nikita-do/VX-Firmware/README.md

# VitalX Firmware

This repository contains the firmware for the pain detection device based on ECG, PPG and EDA/GSR signals. The implementation focuses on reading these from hardware, batching them in memory, packaging, and sending them to a remote broker for analysis and visualization.

### 1. Sensor acquisition

The firmware reads two categories of signals:

- GSR and ECG through the ESP32 ADC inputs
- IR and red PPG values through the ADPD144 sensor

The code uses:

- ADC calibration for reliable analog-to-digital conversion
- oneshot ADC configuration for low-overhead sampling
- FreeRTOS timers to trigger sensor reads at a fixed rate

Current runtime configuration:

- Sampling rate: 512 Hz
- Batch size: 512 samples
- Payload encoding: CBOR

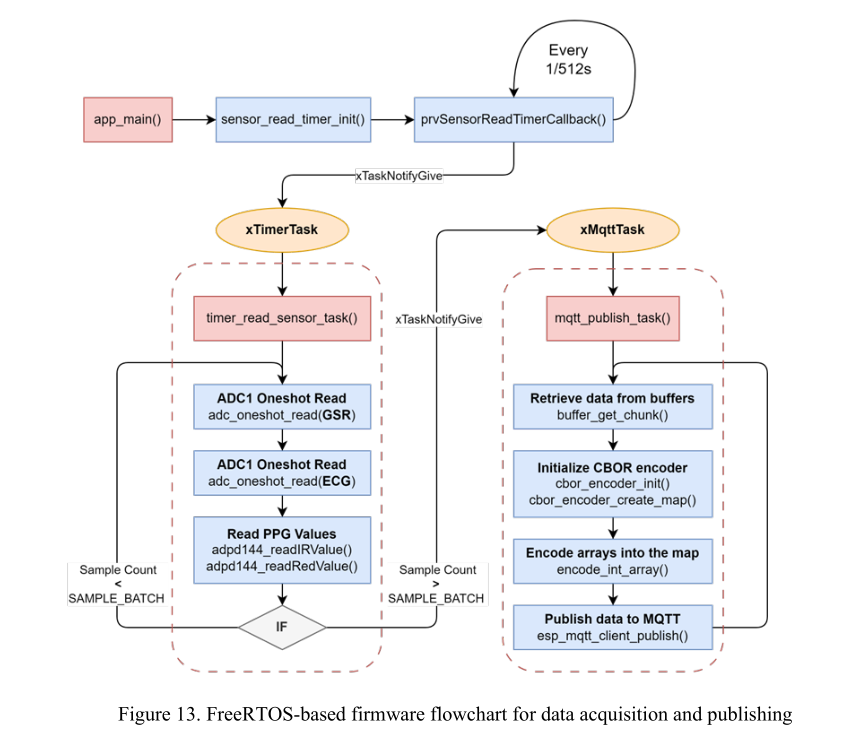
[picture p1: assets/freertos.png]
FreeRTOS sampling and publish flow


### 2. Real-time buffering

The firmware uses circular buffers to handle continuous sampling without blocking or dropping data. Each signal stream has its own buffer:

- GSR buffer
- ECG buffer
- IR buffer
- Red buffer

The sensor task writes samples continuously, and the publish task reads out a full batch later for encoding and publishing.

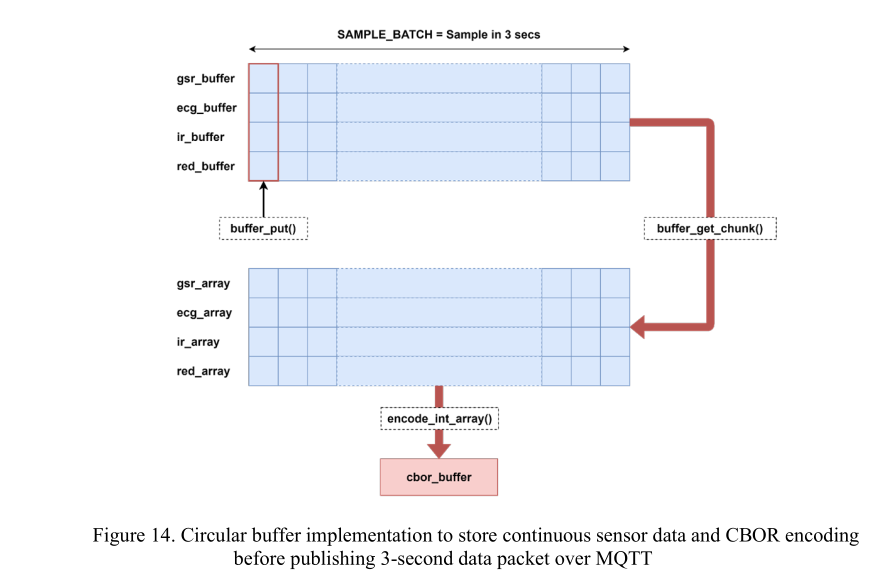
[picture p2: assets/buffer.png]
Circular buffer and CBOR encoding flow


### 3. MQTT communication

The device communicates with a secure MQTT broker using the ESP-IDF MQTT client. The implementation is built around asynchronous event handling, the firmware reacts to connection events, subscriptions, received commands, and errors without blocking the main data path.

The firmware publishes:

- device online status
- firmware version
- sampling metadata
- RSSI information
- CBOR-encoded sensor batches

It also subscribes to command topics to support remote control:

- start data publishing
- stop data publishing
- restart/reset the device

The topic design is intentionally device-scoped, so each ESP32 instance keeps its own data stream and command channels. The device topics are highlighted below.

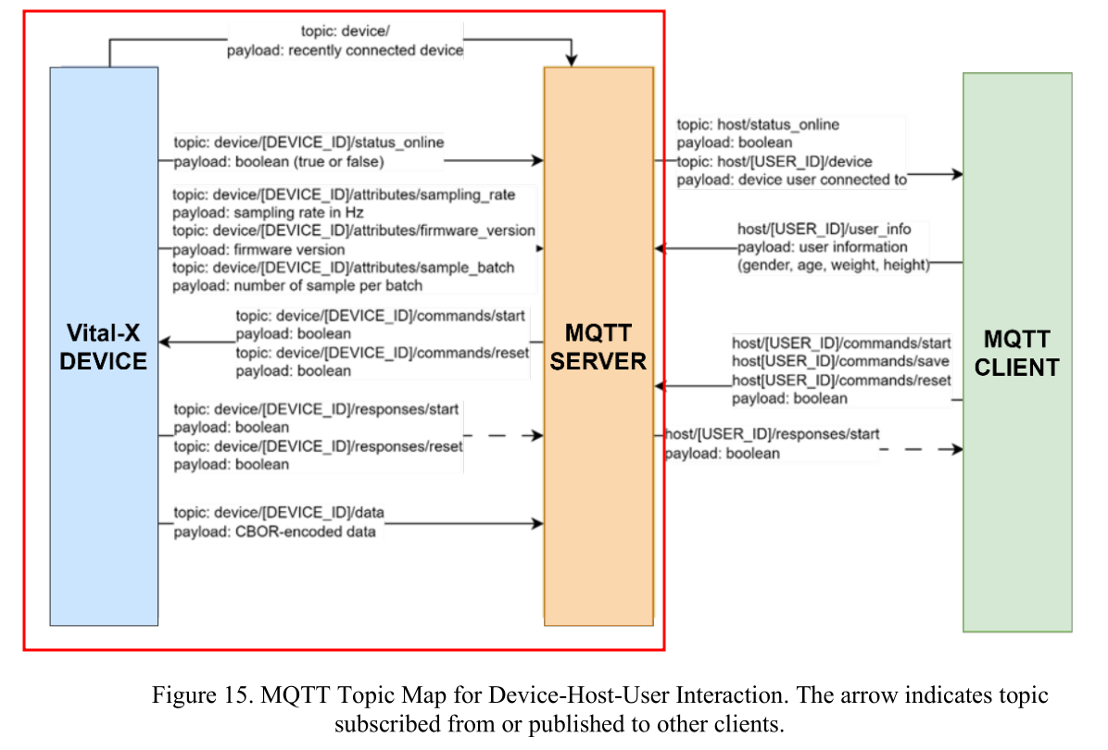
[picture p3: assets/mqtt-topic.png]
MQTT topic map


### 4. Wi-Fi provisioning and connectivity

The device includes Wi-Fi provisioning support using the ESP-IDF provisioning framework. The firmware can be configured at runtime instead of hardcoding credentials into firmware.

The implementation includes:

- SoftAP or BLE provisioning flow
- QR-provisioning support
- NVS-backed credential storage
- reconnect logic after connection loss
- reset/reprovisioning support

### 5. Time synchronization

The firmware synchronizes the local clock using SNTP before producing timestamped sensor packets. This matters because the sensor data is grouped into batches and then published to MQTT. Without a valid time source, the downstream analytics side has no reliable chronology for the readings.

### 6. Device health and operational status

The firmware also includes a few common reliability features:

- LED status indication for connection state
- last-will MQTT messages for offline detection
- restart after repeated disconnects
- optional heap monitoring for debugging memory issues

## Firmware structure

```text
firmware/
└── esp32-VitalX/
    ├── CMakeLists.txt
    ├── sdkconfig
    ├── components/
    │   └── adpd144/
    ├── main/
    │   ├── app_main.c
    │   ├── app_main.h
    │   ├── app_adc.c
    │   ├── app_mqtt.c
    │   ├── app_time.c
    │   ├── circular_buffer.c
    │   ├── wifi_prov.c
    │   ├── Kconfig.projbuild
    │   └── idf_component.yml
    └── managed_components/
```

Key firmware files:

- app_main.c: main application loop, sensor batching, MQTT control, task scheduling
- app_adc.c: ADC calibration and reading logic
- app_mqtt.c: MQTT client configuration and event handling
- app_time.c: SNTP and timestamp handling
- wifi_prov.c: Wi-Fi provisioning and connection flow
- circular_buffer.c: ring-buffer implementation for the sensor streams
- Kconfig.projbuild: custom project configuration for MQTT and Wi-Fi settings

## Build notes

This project uses the ESP-IDF framework and is configured as an ESP32-S2 firmware target.

## References

- ESP-IDF: https://docs.espressif.com/projects/esp-idf/en/latest/esp32/index.html
- ESP SoftAP Provisioning:
https://play.google.com/store/apps/details?id=com.espressif.provsoftap&pcampaignid=web_s
hare
- FreeRTOS: https://www.freertos.org/media/2018/FreeRTOS_Reference_Manual_V10.0.0.pdf
- CBOR Encoding: https://cborbook.com/part_1/practical_introduction_to_cbor.html

---

This README summarizes the implementation that was completed in the current firmware codebase.
