nikita-do/VX-Firmware/assets/system-architecture.png

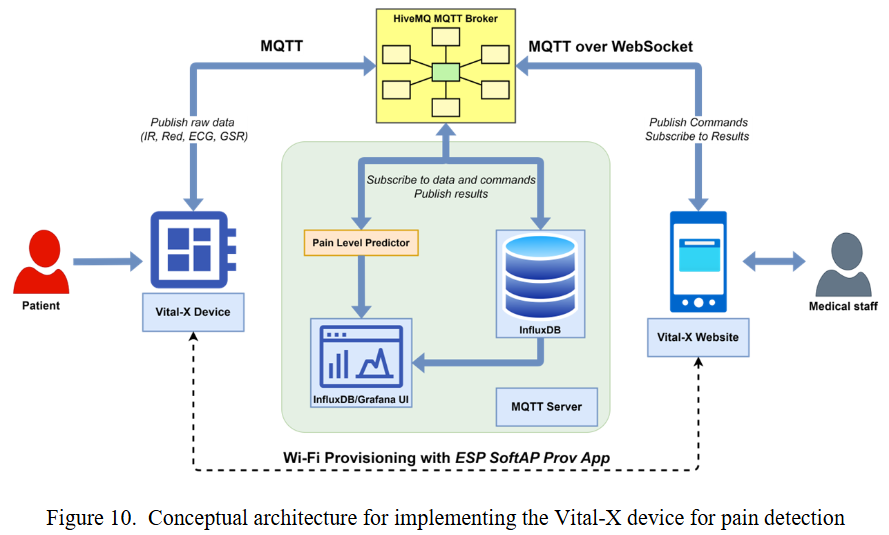
assets/system-architecture.png
