nikita-do/VX-Firmware/hardware/customLib/AD8232ACPZ-R7/AD8232ACPZ-R7.STEP

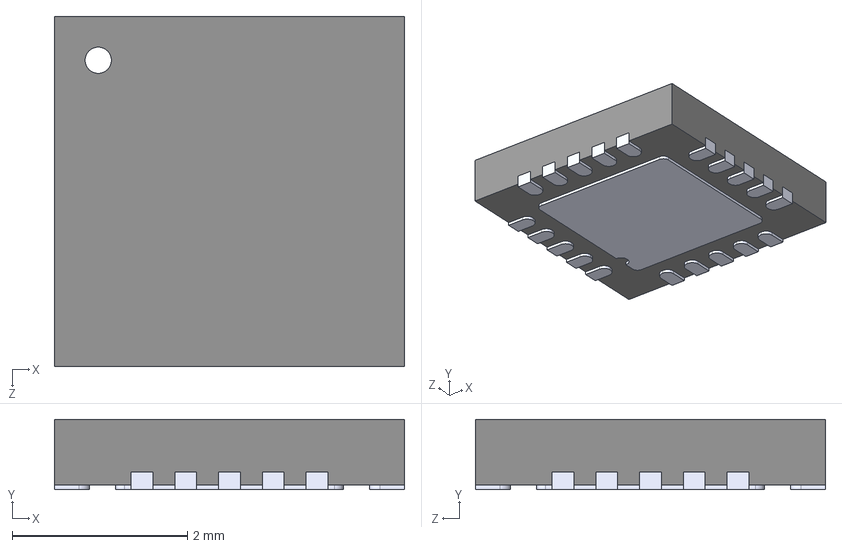
[picture p5: CAD file, 2024-07-22, last stored version]
hardware/customLib/AD8232ACPZ-R7/AD8232ACPZ-R7.STEP
4.00 x 0.8 x 4.00 mm
