nikita-do/VX-Firmware/hardware/customLib/ADP160AUJZ-1-8-R7/ADP160AUJZ-1-8-R7.step

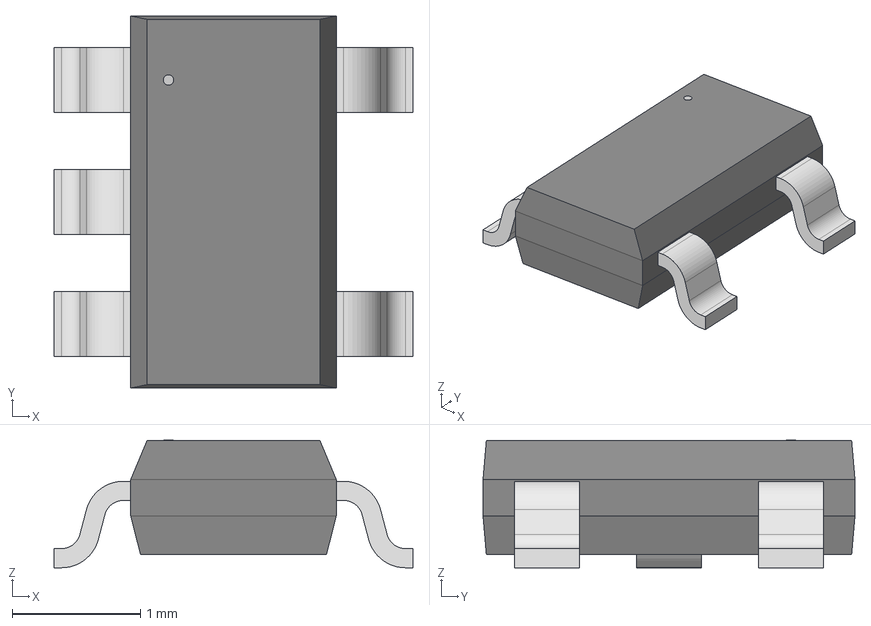
[picture p6: CAD file, 2024-07-22, last stored version]
hardware/customLib/ADP160AUJZ-1-8-R7/ADP160AUJZ-1-8-R7.step
2.79 x 2.90 x 0.993 mm
