nikita-do/VX-Firmware/hardware/customLib/ADPD144RI/CE-12-2_ADI.step

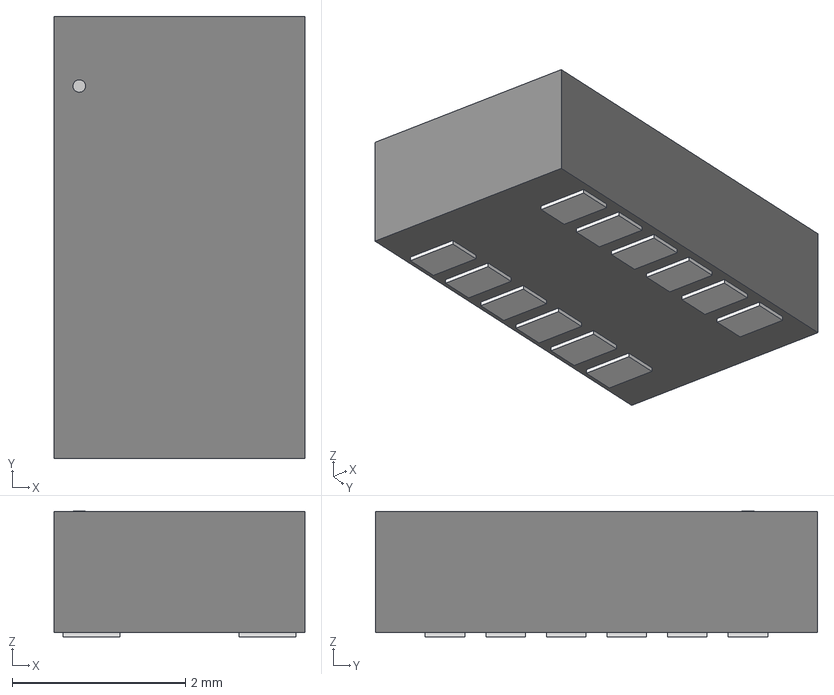
[picture p7: CAD file, 2025-03-10, last stored version]
hardware/customLib/ADPD144RI/CE-12-2_ADI.step
2.90 x 5.11 x 1.45 mm
