nikita-do/VX-Firmware/hardware/customLib/AUDIO/SJ2-3574A-SMT-TR/SJ2-3574A-SMT-TR.step

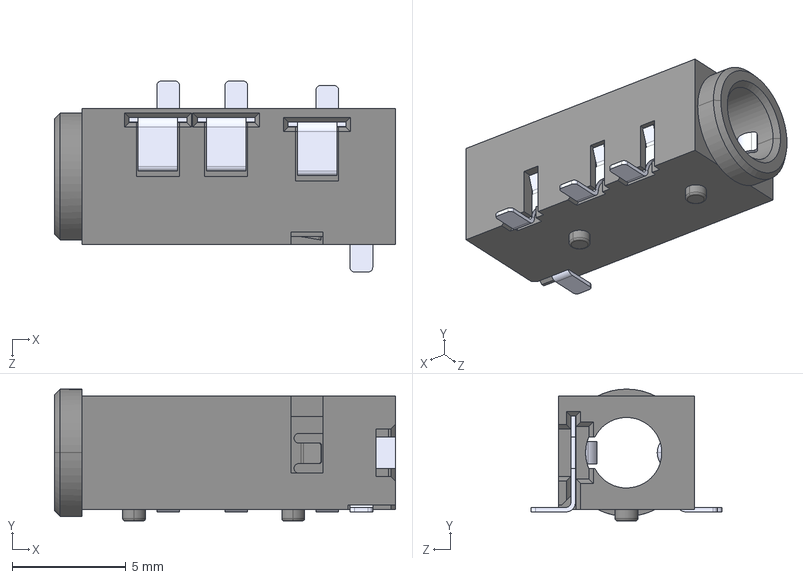
[picture p8: CAD file, 2024-07-22, last stored version]
hardware/customLib/AUDIO/SJ2-3574A-SMT-TR/SJ2-3574A-SMT-TR.step
15.0 x 5.80 x 8.40 mm
