nikita-do/VX-Firmware/hardware/customLib/AUDIO/SJ2-3593D-SMT-TR/SJ2-3593D-SMT-TR.step

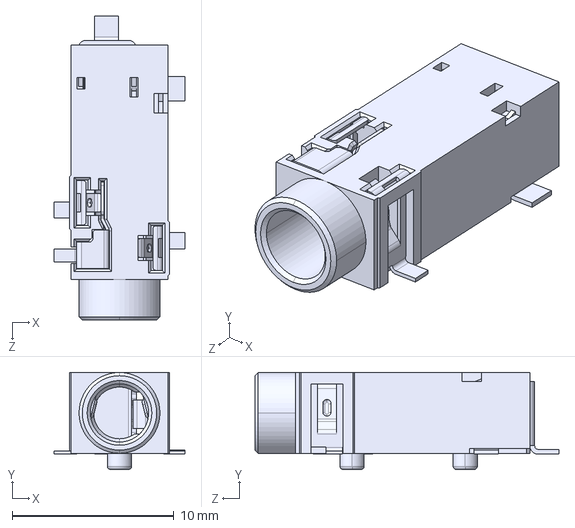
[picture p9: CAD file, 2024-07-22, last stored version]
hardware/customLib/AUDIO/SJ2-3593D-SMT-TR/SJ2-3593D-SMT-TR.step
8.10 x 6.00 x 18.8 mm
