nikita-do/VX-Firmware/hardware/VitalX-ESP/VitalX-ESP.kicad_pcb

## KiCad design hardware/VitalX-ESP/VitalX-ESP.kicad_pcb (2025-03-10, last stored version)

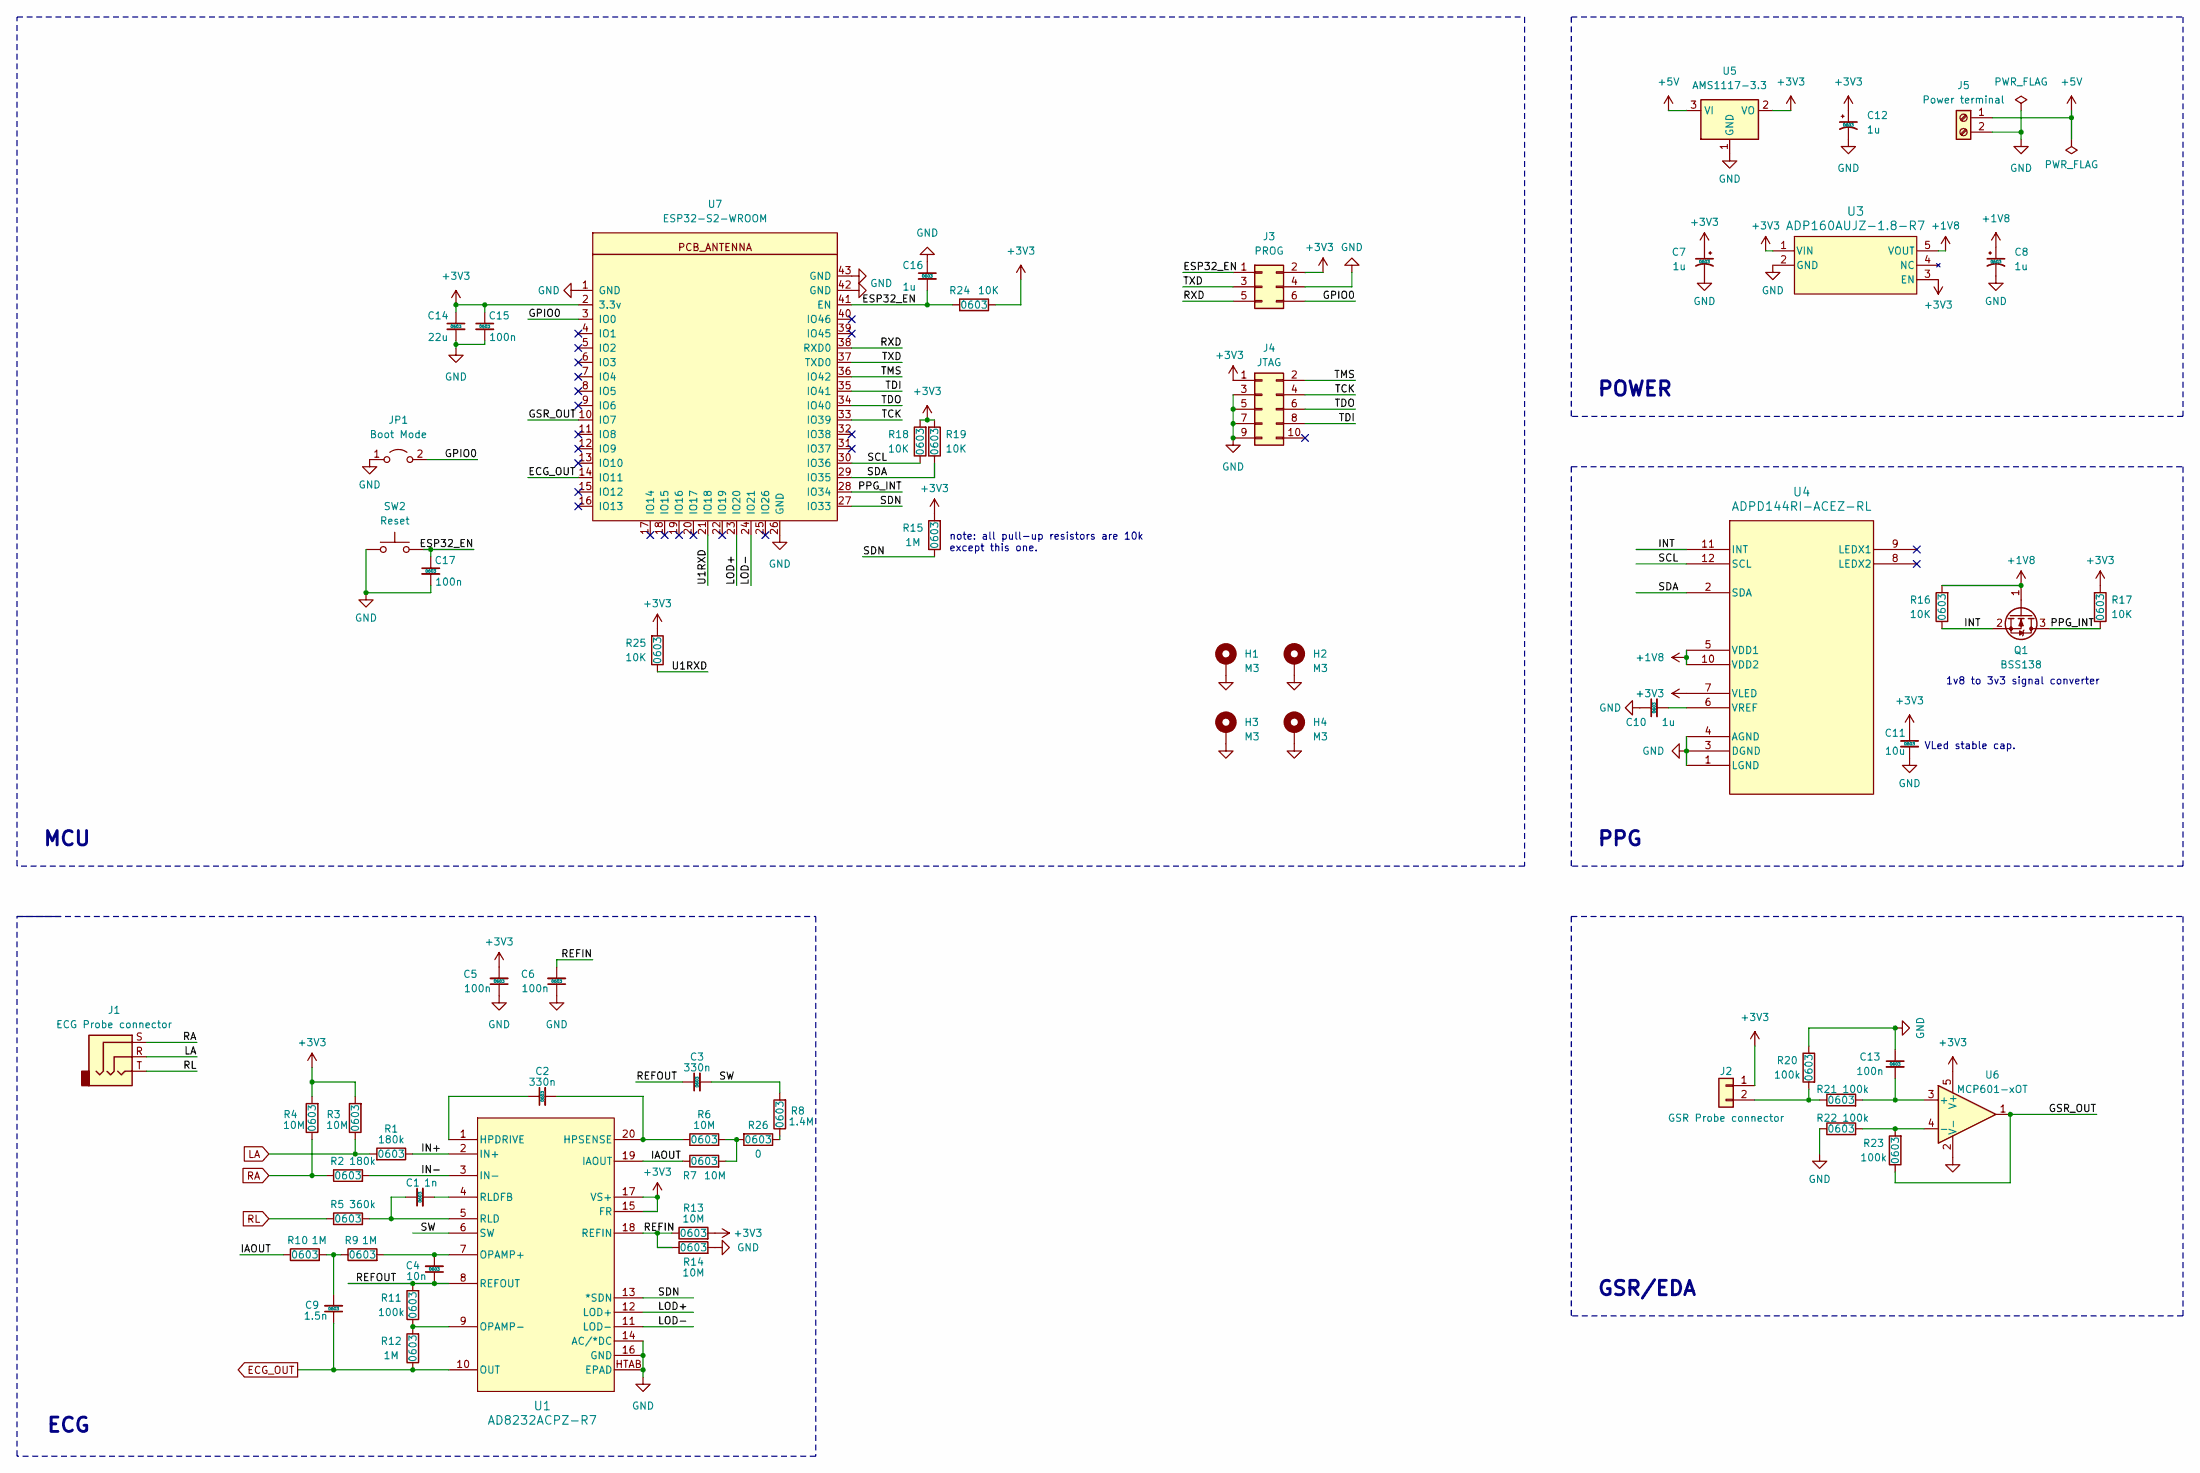
[picture p10: schematic VitalX-ESP.kicad_sch, Vital X]

Parts:
C1: 1n; C_0603_1608Metric
C2, C3: 330n; C_0603_1608Metric
C4: 10n; C_0603_1608Metric
C5, C6, C13, C15, C17: 100n; C_0603_1608Metric
C7, C8, C10, C12, C16: 1u; C_0603_1608Metric
C9: 1.5n; C_0603_1608Metric
C11: 10u; C_0603_1608Metric
C14: 22u; C_0603_1608Metric
H1, H2, H3, H4: M3; MountingHole_3.2mm_M3_Pad_Via
J1: ECG Probe connector; SJ2-3593D-SMT-TR
J2: GSR Probe connector; PinHeader_1x02_P2.54mm_Vertical
J3: PROG; PinHeader_2x03_P2.54mm_Vertical
J4: JTAG; PinHeader_2x05_P2.54mm_Vertical
J5: Power terminal; TerminalBlock_bornier-2_P5.08mm
JP1: Boot Mode; PinHeader_1x02_P2.54mm_Vertical
Q1: BSS138; SOT-23; mouser mnf num 512-BSS138
R1, R2: 180k; R_0603_1608Metric
R3, R4, R6, R7, R13, R14: 10M; R_0603_1608Metric
R5: 360k; R_0603_1608Metric
R8: 1.4M; R_0603_1608Metric
R9, R10, R12, R15: 1M; R_0603_1608Metric
R11, R20, R21, R22, R23: 100k; R_0603_1608Metric
R16, R17, R18, R19, R24, R25: 10K; R_0603_1608Metric
R26: 0; R_0603_1608Metric
SW2: Reset; SW_Tactile_SPST_NO_Straight_CK_PTS636Sx25SMTRLFS
U1: AD8232ACPZ-R7; AD8232ACPZ; mouser mnf num 584-AD8232ACPZ-R7
U3: ADP160AUJZ-1.8-R7; ADP160AUJZ-1-8-R7; mouser mnf num 584-ADP160AUJZ-1.8R7
U4: ADPD144RI-ACEZ-RL; CE-12-2_ADI; mouser mnf num 584-ADPD144RI-ACEZRL
U5: AMS1117-3.3; SOT-223-3_TabPin2; mouser mnf num 926-LM1117MPX3.3NOPB
U6: MCP601-xOT; SOT-23-5; mouser mnf num 579-MCP601RT-E/OT
U7: ESP32-S2-WROOM; esp32-s2-wrooom; mouser mnf num 356-ESP32S2WRMI320US

Connections:
+1V8: C8.1, Q1.1 (G), R16.2, U3.5 (VOUT), U4.5 (VDD1), U4.10 (VDD2)
+3V3: C5.2, C7.1, C11.1, C12.1, C14.1, C15.1, J2.1, J3.2, J4.1, R3.2, R4.2, R13.2, R15.2, R17.2, R18.2, R19.2, R24.1, R25.2, U1.15 (FR), U1.17 (VS+), U3.1 (VIN), U3.3 (EN), U4.7 (VLED), U5.2 (VO), U6.5 (V+), U7.2 (3.3v)
+5V: J5.1, U5.3 (VI)
/ESP32_EN: C16.2, C17.1, J3.1, R24.2, SW2.2, U7.41 (EN)
/GPIO0: J3.6, JP1.2 (B), U7.3 (IO0)
/GSR_OUT: R23.1, U6.1, U7.10 (IO7)
/IAOUT: R7.1, R10.1, U1.19 (IAOUT)
/IN+: R1.1, U1.2 (IN+)
/IN-: R2.2, U1.3 (IN-)
/INT: Q1.2 (S), R16.1, U4.11 (INT)
/LOD+: U1.12 (LOD+), U7.23 (IO20)
/LOD-: U1.11 (LOD-), U7.24 (IO21)
/PPG_INT: Q1.3 (D), R17.1, U7.28 (IO34)
/REFIN: C6.2, R13.1, R14.1, U1.18 (REFIN)
/REFOUT: C3.1, C4.1, R11.2, U1.8 (REFOUT)
/RXD: J3.5, U7.38 (RXD0)
/SCL: R18.1, U4.12 (SCL), U7.30 (IO36)
/SDA: R19.1, U4.2 (SDA), U7.29 (IO35)
/SDN: R15.1, U1.13 (*SDN), U7.27 (IO33)
/SW: C3.2, R8.2, U1.6 (SW)
/TCK: J4.4, U7.33 (IO39)
/TDI: J4.8, U7.35 (IO41)
/TDO: J4.6, U7.34 (IO40)
/TMS: J4.2, U7.36 (IO42)
/TXD: J3.3, U7.37 (TXD0)
/U1RXD: R25.1, U7.21 (IO18)
ECG_OUT: C9.1, R12.1, U1.10 (OUT), U7.14 (IO11)
GND: C5.1, C6.1, C7.2, C8.2, C10.1, C11.2, C12.2, C13.1, C14.2, C15.2, C16.1, C17.2, H1.1, H2.1, H3.1, H4.1, J3.4, J4.3, J4.5, J4.7, J4.9, J5.2, JP1.1 (A), R14.2, R20.1, R22.1, SW2.1, U1.14 (AC/*DC), U1.16 (GND), U1.HTAB (EPAD), U3.2 (GND), U4.1 (LGND), U4.3 (DGND), U4.4 (AGND), U5.1 (GND), U6.2 (V-), U7.1 (GND), U7.26 (GND), U7.42 (GND), U7.43 (GND)
LA: J1.R, R1.2, R3.1
unnamed: C9.2, R9.1, R10.2
unnamed: J2.2, R20.2, R21.1
unnamed: R8.1, R26.1
unnamed: R6.2, R7.2, R26.2
unnamed: C2.1, U1.1 (HPDRIVE)
unnamed: C2.2, R6.1, U1.20 (HPSENSE)
unnamed: C4.2, R9.2, U1.7 (OPAMP+)
unnamed: R11.1, R12.2, U1.9 (OPAMP-)
unnamed: C1.1, R5.2, U1.5 (RLD)
unnamed: C1.2, U1.4 (RLDFB)
unnamed: C10.2, U4.6 (VREF)
unnamed: C13.2, R21.2, U6.3 (+)
unnamed: R22.2, R23.2, U6.4 (-)
RA: J1.S, R2.1, R4.1
RL: J1.T, R5.1

Notes on the sheet:
MCU
PPG
1v8 to 3v3 signal converter
GSR/EDA
ECG
VLed stable cap.
note: all pull-up resistors are 10k except this one.
POWER

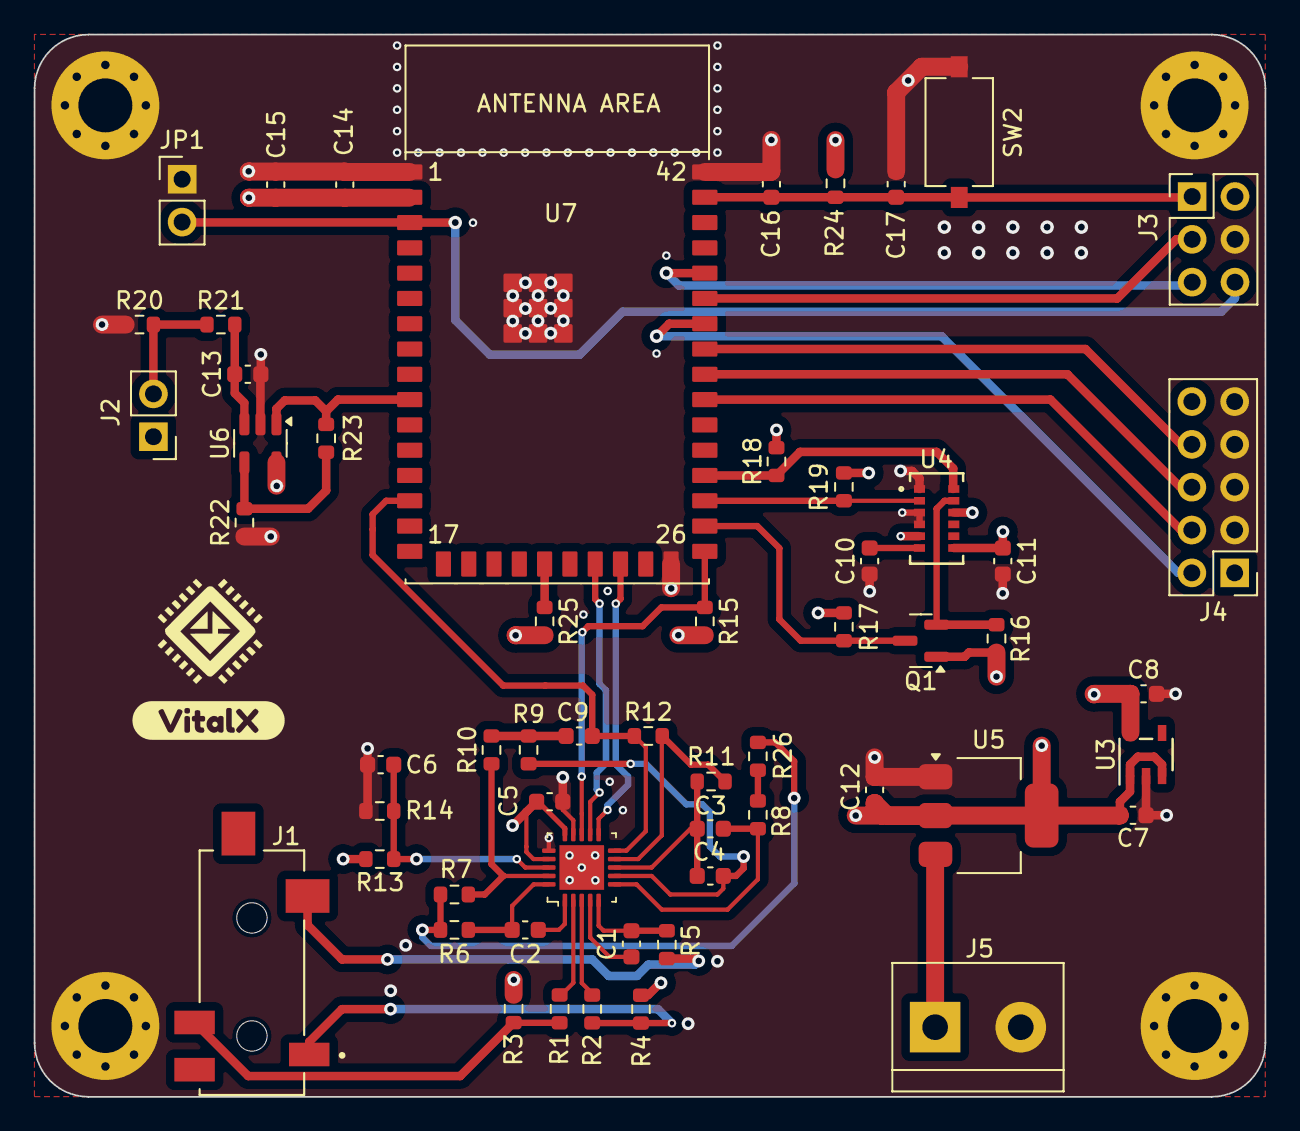
[picture p11: board VitalX-ESP.kicad_pcb from above]

Board: 4 copper layers, 73.0 x 63.0 mm, 62 parts (0 on the bottom side), 44 nets.

Other parts of the board:
kibuzzard-673C1CE7: G***; kibuzzard-673C1CE7
