nikita-do/VX-Firmware/firmware/esp32-VitalX/components/adpd144/adpd144.c

// Written for only one device on the i2c bus
/* ------------------------- Includes -------------------------------------- */
#include <stdint.h>
#include <stdlib.h>
#include "adpd144.h"
#include "esp_check.h"

i2c_adpd144_t dev_handle;

static const char LOG_TAG[] = "i2c-adpd";

// ADPD144 default configuration. Register's values is set in an array
const adpd144_register_t register_config[] = {
    {REG_MODE, 0x0001},                 // program mode
    {REG_SAMPLE_CLK, 0x0080},           // start the sample clock (32 kHz)
    {REG_INT_IO_CTL, 0x0005},           // enable interrupt drive
    {REG_SLOT_EN, 0x30A9},
    {REG_F_SAMPLE, 0x0001},             // sampling rate = 1000 Hz
    {REG_PD_LED_SELECT, 0x0116},        // 
    {REG_NUM_AVG, 0x0330},              // Average sample = 8
    {REG_SLOTA_CH1_OFFSET, 0x3FFF},     // not used
    {REG_SLOTA_CH2_OFFSET, 0x3FFF},     // not used
    {REG_SLOTA_CH3_OFFSET, 0x1FF0},     // half scale
    {REG_SLOTA_CH4_OFFSET, 0x1FF0},     // half scale
    {REG_SLOTB_CH1_OFFSET, 0x3FFF},     // not used
    {REG_SLOTB_CH2_OFFSET, 0x3FFF},     // not used
    {REG_SLOTB_CH3_OFFSET, 0x1FF0},
    {REG_SLOTB_CH4_OFFSET, 0x1FF0},
    {REG_ILED1_COARSE, 0x3005},
    {REG_ILED2_COARSE, 0x3007},
    {REG_ILED_FINE, 0x0207},
    {REG_SLOTA_LEDMODE, 0x0319},
    {REG_SLOTA_NUMPULSES, 0x0813},
    {REG_SLOTB_LEDMODE, 0x0319},
    {REG_SLOTB_NUMPULSES, 0x0813},
    {REG_SLOTA_AFEMODE, 0x21F3},
    {REG_SLOTB_AFEMODE, 0x21F3},
    {REG_SLOTA_GAIN, 0x1C36},           // TIA gain = 50k
    {REG_SLOTB_GAIN, 0x1C36},           // TIA gain = 50k
    {REG_ADC_TIMING, 0x0040},
    {REG_MODE, 0x0002},                 // sample mode
    {0xFF, 0xFFFF}                      // signal the end of list
};

/**
 *  @brief    Load ADPD default configuration
 *  @param    adpd144_register_t *cfg
 *  @retval   None
 */
void adpd144_loadConfig(const adpd144_register_t *cfg)
{
    uint8_t regAddr, i;
    uint16_t regData;
    if (cfg == 0)
        return;
    /* Clear the FIFO */
    adpd144_writeReg(REG_MODE, 1);      // Program mode
    adpd144_writeReg(REG_DATA_ACCESS_CTL, 1);      // Set the FIFO_ACCESS_ENA to 1
    adpd144_writeReg(REG_STATUS, 0x80FF); // Set the FIFO_FLUSH to 0x80FF
    adpd144_writeReg(REG_DATA_ACCESS_CTL, 0);      // Set the FIFO_ACCESS_ENA to 0
    i = 0;
    while (1)
    {
        /* Read the address and data from the config */
        regAddr = (uint8_t)(cfg[i].address);
        regData = (uint16_t)(cfg[i].value);
        i++;
        if (regAddr == 0xFF)
            break;
        /* Load the data into the ADPD registers */
        adpd144_writeReg(regAddr, regData);
    }
}

/**
 * @brief    Read Infrared Red value from Slot A
 * @param    data Pointer to store the read value
 * @param    len Length of data to read (1 for 16-bit, 2 for 32-bit)
 */
esp_err_t adpd144_readIRValue(uint32_t *data, uint8_t len)
{
    uint16_t anRxData[2] = {0};
    uint8_t regAddr[2];

    /* Time slot requiring access */
    adpd144_writeReg(REG_DATA_ACCESS_CTL, 1); // Prevent slot A data from updating

    if (len == 1)
    {
        regAddr[0] = REG_SLOTA_PD4_16_BIT; // Average data
    }
    else if (len == 2)
    {
        regAddr[0] = REG_SLOTA_PD4_LOW; // Low data-word 
        regAddr[1] = REG_SLOTA_PD4_HIGH; // High data-word 
    }
    else
    {
        ESP_LOGE(LOG_TAG, "Invalid length for adpd144_ReadReg_SlotA");
        return ESP_ERR_INVALID_ARG;
    }

    for (int i = 0; i < len; i++)
    {
        adpd144_readReg(regAddr[i], &anRxData[i]);
    }

    if (len == 1)
    {
        *data = anRxData[0];
    }
    else if (len == 2)
    {
        *data = (anRxData[1] << 16) + anRxData[0];
    }

    adpd144_writeReg(REG_DATA_ACCESS_CTL, 0); // Allow slot A data to update

    return ESP_OK;
}

/**
 * @brief    Read Red value from Slot B
 * @param    data Pointer to store the read value
 * @param    len Length of data to read (1 for 16-bit, 2 for 32-bit)
 */
esp_err_t adpd144_readRedValue(uint32_t *data, uint8_t len)
{
    uint16_t anRxData[2] = {0};
    uint8_t regAddr[2];

    /* Time slot requiring access */
    adpd144_writeReg(REG_DATA_ACCESS_CTL, 3); // Prevent slot B data from updating

    if (len == 1)
    {
        regAddr[0] = REG_SLOTB_PD4_16_BIT; // Average data
    }
    else if (len == 2)
    {
        regAddr[0] = REG_SLOTB_PD4_LOW; // Low data-word
        regAddr[1] = REG_SLOTB_PD4_HIGH; // High data-word
    }
    else
    {
        ESP_LOGE(LOG_TAG, "Invalid length for adpd144_ReadReg_SlotB");
        return ESP_ERR_INVALID_ARG;
    }

    for (int i = 0; i < len; i++)
    {
        adpd144_readReg(regAddr[i], &anRxData[i]);
    }

    if (len == 1)
    {
        *data = anRxData[0];
    }
    else if (len == 2)
    {
        *data = (anRxData[1] << 16) + anRxData[0];
    }

    adpd144_writeReg(REG_DATA_ACCESS_CTL, 0); // Allow slot B data to update

    return ESP_OK;
}

/**
 * @brief    Initialize the ADPD144 device
 * 
 * This function configures the I2C bus and initializes the ADPD144 device.
 * It reads the chip ID to verify communication.
 */
esp_err_t adpd144_init(void)
{
    esp_err_t ret = ESP_OK;

    ESP_LOGI(LOG_TAG, "Configuring i2c bus");
    i2c_master_bus_config_t i2c_bus_config = {
        .clk_source = I2C_CLK_SRC_DEFAULT,
        .i2c_port = PORT_NUMBER,
        .scl_io_num = I2C_SCL_IO_PIN,
        .sda_io_num = I2C_SDA_IO_PIN,
        .glitch_ignore_cnt = 7,
    };
    i2c_master_bus_handle_t bus_handle;
    ESP_ERROR_CHECK(i2c_new_master_bus(&i2c_bus_config, &bus_handle));

    dev_handle.i2c_dev_conf.scl_speed_hz = MASTER_FREQUENCY;
    dev_handle.i2c_dev_conf.device_address = DEVICE_ADDRESS;

    ret = i2c_master_bus_add_device(bus_handle, &dev_handle.i2c_dev_conf, &dev_handle.i2c_dev_handle);
    ESP_GOTO_ON_ERROR(ret, cleanup, LOG_TAG, "i2c new bus failed");

    /* Start reading the IC */
    uint16_t chip_id; // Buffer to store the received data

    adpd144_readReg(REG_CHIP_ID, &chip_id);
    ESP_LOGI(LOG_TAG, "ADPD144 REG_CHIP_ID: %x", chip_id);
    return ESP_OK;

cleanup:
    if (dev_handle.i2c_dev_handle)
    {
        ESP_ERROR_CHECK(i2c_master_bus_rm_device(dev_handle.i2c_dev_handle));
    }
    return ret;
}

/**
 * @brief  Start the ADPD144 device
 *
 * This function initializes the ADPD144 device with a default configuration.
 */
void adpd144_start(void)
{
    adpd144_loadConfig(register_config); // Load the default configuration
}

/**
 * @brief  Stop the ADPD144 device
 *
 * This function puts the ADPD144 into standby mode.
 */
void adpd144_stop(void)
{
    adpd144_writeReg(REG_MODE, 0);      // Standby mode
}

/** @brief  Synchronous register read from the ADPD
 *
 * @param  nAddr 8-bit register address
 * @param  *pnData Pointer to 16-bit register data value
 */
void adpd144_readReg(uint8_t nAddr, uint16_t *pnData)
{
    uint8_t anRxData[2];

    ESP_ERROR_CHECK(i2c_master_transmit_receive(dev_handle.i2c_dev_handle, &nAddr, REG_ADDR_NUM_BYTES, anRxData, REG_VALUE_NUM_BYTES, -1));

    *pnData = ((uint16_t)anRxData[0] << 8) + anRxData[1];
}

/** @brief  Synchronous register write to the ADPD
 *
 * @param  nAddr 8-bit register address
 * @param  nRegValue 16-bit register data value
 */
void adpd144_writeReg(uint8_t nAddr, uint16_t nRegValue)
{
    dev_handle.buffer[0] = nAddr;
    dev_handle.buffer[1] = (uint8_t)(nRegValue >> 8);
    dev_handle.buffer[2] = (uint8_t)(nRegValue);

    ESP_ERROR_CHECK(i2c_master_transmit(dev_handle.i2c_dev_handle, dev_handle.buffer,REG_ADDR_NUM_BYTES + sizeof(uint16_t), -1));
}

/* ------------------------- End of file ----------------------------------- */
