nikita-do/VX-Firmware/firmware/esp32-VitalX/main/app_main.h

/**
 * @file app_main.h
 * @brief Contain shared libraries, structures, functions, and macros between source files
 * @todo Create header files for each source file
 * 
 * @version 0.2.0
 * @date 2024-04-09
 * 
 */

#ifndef APP_MAIN_H
#define APP_MAIN_H

#define SAMPLING_RATE 512  // Hz                
#define N_SAMPLE 512 // Number of samples to be sent in one batch

#define LED_BLINK_PERIOD_DISCONNECTED 200 // ms
#define LED_BLINK_PERIOD_PROVISIONING 500 // ms

/* C-Standard headers */
#include <stdio.h>
#include <stdint.h>
#include <stddef.h>
#include <string.h>
#include <stdlib.h>
#include <inttypes.h>

/* FreeRTOS headers */
#include "freertos/FreeRTOS.h"
#include "freertos/task.h"
#include "freertos/event_groups.h"
#include "freertos/semphr.h"
#include "freertos/queue.h"

/* ESP32 supported headers */
#include "esp_log.h"
#include "esp_system.h"
#include "esp_event.h"
#include <nvs_flash.h>

#include "esp_adc/adc_oneshot.h"
#include "esp_adc/adc_cali.h"

// #include "driver/gpio.h"

extern char mqtt_topics_firmware_version[64];
extern char mqtt_topics_sampling_rate[64];
extern char mqtt_topics_sample_batch[64];
extern char mqtt_topics_status_online[64];
extern char mqtt_topics_commands[64];
extern char mqtt_topics_commands_start[64];
extern char mqtt_topics_commands_reset[64];
extern char mqtt_topics_responses_start[64];
extern char mqtt_topics_responses_reset[64];
extern char mqtt_topics_data[64];

// app_adc.c
typedef struct
{
    adc_unit_t adc_unit;                   // ADC unit
    adc_channel_t channel;                 // ADC channel
    adc_oneshot_unit_handle_t unit_handle; // ADC oneshot unit handle
    adc_cali_handle_t cali_handle;         // ADC calibration handle
    int raw_value;                         // Raw ADC reading
    int voltage_value;                         // Voltage reading in mV
} AdcConfig_t;

esp_err_t adc_calibration_init(adc_unit_t unit, adc_channel_t channel, adc_cali_handle_t *out_handle);
void adc_calibration_deinit(adc_cali_handle_t handle);
esp_err_t adc_oneshot_init(adc_unit_t unit, adc_channel_t channel, adc_oneshot_unit_handle_t *out_adc_handle, adc_cali_handle_t *out_cali_handle);

// app_mqtt.c
void log_error_if_nonzero(const char *message, int error_code);
void mqtt_app_start(void);

//app_time.c
void check_time(void);
uint64_t get_timestamp();

// wifi_prov.c
void wifi_provisioning(void);
void update_led_blink_period(uint32_t period);
extern char service_name[12];

// circular_buffer.c
#define BUFFER_SIZE 2048
#define BUFFER_NAME_MAX_LEN 3

#if (BUFFER_SIZE & (BUFFER_SIZE - 1)) != 0
#error "BUFFER_SIZE must be a power of two."
#endif

typedef struct {
    uint16_t buffer[BUFFER_SIZE];
    uint16_t write;
    uint16_t read; // mark the next read position (the end of the buffer)
    char name[BUFFER_NAME_MAX_LEN];
} CircularBuffer_t;

void buffer_init(CircularBuffer_t *cb, const char *name);
bool buffer_is_empty(CircularBuffer_t *cb);
bool buffer_is_full(CircularBuffer_t *cb);
size_t buffer_data_count(CircularBuffer_t *cb);
size_t buffer_distance(size_t from, size_t to);
void buffer_put(CircularBuffer_t *cb, uint16_t data);
bool buffer_get_chunk(CircularBuffer_t *cb, uint16_t *temp_buffer, size_t sample_size);
void buffer_print(CircularBuffer_t *cb);

        
#endif // APP_MAIN_H
