nikita-do/VX-Firmware/firmware/esp32-VitalX/main/app_adc.c

#include "app_main.h"

#include "esp_adc/adc_cali_scheme.h"
static const char *TAG = "app_adc";
/*---------------------------------------------------------------
        ADC Line Fitting Calibration
---------------------------------------------------------------*/
esp_err_t adc_calibration_init(adc_unit_t unit, adc_channel_t channel, adc_cali_handle_t *out_handle)
{
    adc_cali_handle_t handle = NULL;
    esp_err_t ret = ESP_FAIL;

    ESP_LOGI(TAG, "calibration scheme version is %s", "Line Fitting");
    adc_cali_line_fitting_config_t cali_config = {
        .unit_id = unit,
        .atten = ADC_ATTEN_DB_12,
        .bitwidth = ADC_BITWIDTH_DEFAULT,
    };
    ret = adc_cali_create_scheme_line_fitting(&cali_config, &handle);

    *out_handle = handle;
    if (ret == ESP_OK)
    {
        ESP_LOGI(TAG, "Calibration Success");
    }
    else if (ret == ESP_ERR_NOT_SUPPORTED)
    {
        ESP_LOGW(TAG, "eFuse not burnt, skip software calibration");
    }
    else
    {
        ESP_LOGE(TAG, "Invalid arg or no memory");
    }

    return ret;
}

void adc_calibration_deinit(adc_cali_handle_t handle)
{
    ESP_LOGI(TAG, "deregister %s calibration scheme", "Line Fitting");
    ESP_ERROR_CHECK(adc_cali_delete_scheme_line_fitting(handle));
}

/*---------------------------------------------------------------
        Init Functions
---------------------------------------------------------------*/
esp_err_t adc_oneshot_init(adc_unit_t unit, adc_channel_t channel, adc_oneshot_unit_handle_t *out_adc_handle, adc_cali_handle_t *out_cali_handle)
{
    adc_cali_handle_t cali_handle = NULL;
    adc_oneshot_unit_handle_t adc_handle = NULL;
    //-------------ADC1 Init---------------//
    adc_oneshot_unit_init_cfg_t init_config = {
        .unit_id = unit,
    };
    ESP_ERROR_CHECK(adc_oneshot_new_unit(&init_config, &adc_handle));

    //-------------ADC1 Config---------------//
    adc_oneshot_chan_cfg_t config = {
        .atten = ADC_ATTEN_DB_12,
        .bitwidth = ADC_BITWIDTH_DEFAULT,
    };
    ESP_ERROR_CHECK(adc_oneshot_config_channel(adc_handle, channel, &config));

    //-------------ADC1 Calibration Init---------------//
    ESP_ERROR_CHECK(adc_calibration_init(unit, channel, &cali_handle));

    *out_adc_handle = adc_handle;
    *out_cali_handle = cali_handle;

    return ESP_OK;
}
