nikita-do/VX-Firmware/(commit log)

2024-07-22 Init hardware project
    [AD8232ACPZ-R7.STEP, ADP160AUJZ-1-8-R7.step, SJ2-3574A-SMT-TR.step, SJ2-3593D-SMT-TR.step, VitalX-ESP.kicad_pcb, VitalX-ESP.kicad_sch]
2024-07-22 [VTX-5] Update gitignore. Remove *.kicad_prl
2024-07-25 [VTX-5] Finalize ECG Block. Minor changes: - Remove cache, bak files. - Change AD8232's EPAD electrical type for ERC. - Update footprint path.
    [VitalX-ESP.kicad_sch]
2024-08-05 [VTX-6] Add symbol/footprint.
    Added ADPD144RI PPG symbol and footprint.
    [CE-12-2_ADI.step]
2024-08-05 [VTX-6] Initialize PPG Block.
    Initial implementation of ADPD144RI.
    [VitalX-ESP.kicad_sch]
2024-08-24 [VTX-6] Finalize PPG Block.
    Included AMS1117-3.3V voltage regulator.
    Increased Vled capacitor from 1uF to 10uF.
    Pull up resistor on ADPD144RI I2C line.
    [VitalX-ESP.kicad_sch]
2024-08-26 [VTX-7] Initialize GSR Block.
    Initial implementation of GSR/EDA readout circuit.
    [VitalX-ESP.kicad_sch]
2024-08-26 [nightly] ESP32-WROOM -> ESP32-S2-WROOM
2024-08-26 [nightly] Initial esp32-s2-wroom configuration.
    [VitalX-ESP.kicad_sch]
2024-08-27 [nightly] Connect peripherals.
    [VitalX-ESP.kicad_sch]
2024-08-30 [nightly] Finalize schematic, ERC exclutions.
    Exclude typical power-in power-out ERC errors.
    [VitalX-ESP.kicad_sch]
2024-08-30 [nightly] Asign footprint.
    [VitalX-ESP.kicad_sch]
2024-08-31 [nightly] Finalize schematic.
    Added power connector.
    [VitalX-ESP.kicad_sch]
2024-09-01 [nightly] Solving ERC.
    [VitalX-ESP.kicad_sch]
2024-09-01 [nightly] Initial PCB layout.
    4 layer stack up:
    - Signal
    - GND
    - GND
    - Signal
    Currently working on ECG Block.
    [VitalX-ESP.kicad_pcb, VitalX-ESP.kicad_sch]
2024-09-04 [nightly] Change ECG Probe connector.
    Utilized PJ-320D for ECG Probe connector.
    [VitalX-ESP.kicad_sch]
2024-09-04 [nightly] Inital signals routing.
    First iteration of signals (only) routing.
    [VitalX-ESP.kicad_pcb]
2024-09-06 [nightly] Change naming convertion.
    +3.3V -> +3V3.
    [VitalX-ESP.kicad_sch]
2024-09-06 [nightly] Finalize board layout.
    [VitalX-ESP.kicad_pcb]
2024-09-06 [nightly] Change ECG Probe footprint.
    Changes in accordance with reference design.
    - https://www.snapeda.com/parts/SJ2-3593D-SMT-TR/CUI%20Devices/view-part/?ref=mouser
    - https://easyeda.com/editor#project_id=8294b8a1d6874413ae900972098163d6
    [VitalX-ESP.kicad_pcb, VitalX-ESP.kicad_sch]
2024-09-06 [nightly] Resolve DRC.
    [VitalX-ESP.kicad_pcb]
2024-09-13 [nightly] Switch to through via only.
    [VitalX-ESP.kicad_pcb]
2024-09-13 [nightly] Adhere to the ECG connector standard.
    Mimic Adafruit ECG probe connector design.
    [VitalX-ESP.kicad_sch]
2024-09-15 [nighly] Various PCB update.
    PCB stack-up change: Signal-GND-Power(3.3V)-Signal
    Track width in mil: 10, 15, 20, 42
    Via size in mil(dia/hole): 20/10, 15/30
    Show ECG Probe 3D model
    Obfuscate 1.8V track
    [VitalX-ESP.kicad_pcb]
2024-09-20 [nightly] Program/Debug interface.
    Implementing proper program connector (2x3) and jtag (2x5)
    [VitalX-ESP.kicad_pcb, VitalX-ESP.kicad_sch]
2024-09-29 [nightly] Various footprint update.
    Change footprints:
    - Reset button
    - GSR conn header
    Minor PCB changes:
    - Increase thermal relief via size
    [VitalX-ESP.kicad_pcb, VitalX-ESP.kicad_sch]
2024-09-30 [nightly] Various footprint update.
    Footprint changes:
    - Boot select SMD -> Through-hole
    [VitalX-ESP.kicad_pcb, VitalX-ESP.kicad_sch]
2024-10-06 [nightly] ESP32-S2-WROOM 3d model
2024-10-06 [nightly] Finallize PCB
    Seperate Antenna ground plane
    Add grounded mounting hole
    Add logo
    [VitalX-ESP.kicad_pcb, VitalX-ESP.kicad_sch]
2024-11-19 Update for fabrication: Add top&bot layer mass, change logo, add GND vias, refine text
    [VitalX-ESP.kicad_pcb]
2025-04-03 send data as a batch of sensor readings, Fs = 100Hz
2025-04-12 Firmware update: WiFi Provisioning
    - remove wifi_stat with hardcoded credentials
    - restart esp32 and clear nvs when disconnected from AP
    - modify service name with prefix VX_ (VitalX)
2025-04-13 Firmware update: version 0.2.0
    - restructure mqtt topics
    - add led indicator for wifi connectivity
2025-04-16 Firmware: v0.2.1
    - Increased sampling rate to 250 Hz.
    - Encoded data as CBOR before sending to MQTT broker.
    - Improved LED indicator
    - Published sampling rate and number of samples per batch to MQTT
    Update .gitignore
    [adpd144.c, app_main.c, app_main.h, app_mqtt.c]
2025-05-04 update sampling rate to 512 Hz
2025-05-13 firmware updated: bug fixed (v0.2.2)
    - Fixed bug related to circular buffer
    - Added feature: specific device id for topic name
    firmware v0.2.2
    [app_main.c, app_main.h, app_mqtt.c, circular_buffer.c, wifi_prov.c]
2025-05-18 bug fixed: not publish device ID
    [app_main.c]
2025-05-30 firmware v0.3.0 - 3s/batch, fs = 512 Hz
2025-07-17 add packet_id, epoch timestamp, change led_gpio
2026-09-28 removed artifact, updated readme
    [AD8232ACPZ-R7.STEP, ADP160AUJZ-1-8-R7.step, CE-12-2_ADI.step, SJ2-3574A-SMT-TR.step, SJ2-3593D-SMT-TR.step, VitalX-ESP.kicad_pcb, VitalX-ESP.kicad_sch]
